Danafra/Zaribo-MK2/STL/Y-axis/Read me.txt

# of parts needed:

Part name:			Amount:
y-BeltHolder MK2		1
y-BeltTensioner-Part1		1
y-BeltTensioner-Part2		1
Y-MotorHolder			1
Y-MotorHolderSupport		1
Y-RodHolder-ZipTie		4
