Danafra/Zaribo-MK2/STL/Frame/Rambo/Read me.txt

# of parts needed:

Part name:			Amount:
RamboBox-Mosfet-Body		1
RamboBox-Mosfet-Cover		1
