Danafra/Zaribo-MK2/STEP/Frame/Frame Components/ExtrusionCover-4x-2.0.step

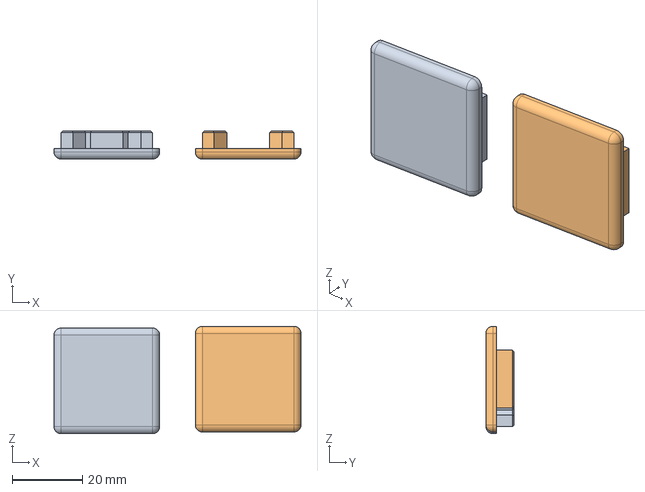
[picture p1: CAD file, 2018-03-04]
STEP/Frame/Frame Components/ExtrusionCover-4x-2.0.step
70.1 x 8.02 x 30.5 mm
