Danafra/Zaribo-MK2/STEP/Frame/PSU/PSU-Z-Connector-1x-2.0.step

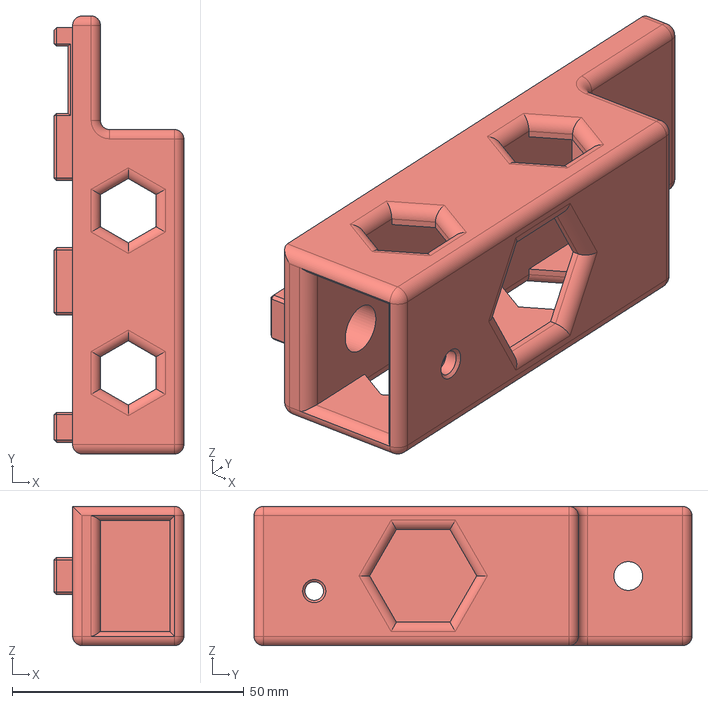
[picture p2: CAD file, 2018-03-04]
STEP/Frame/PSU/PSU-Z-Connector-1x-2.0.step
28.0 x 94.5 x 30.0 mm
