Danafra/Zaribo-MK2/STEP/Frame/Rambo/RamboBox-Mosfet-1x-2.0 v1.step

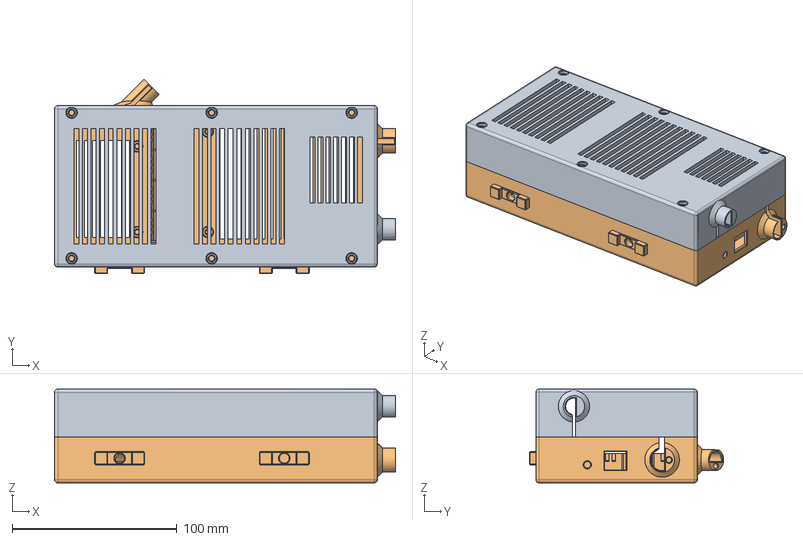
[picture p3: CAD file, 2018-03-04]
STEP/Frame/Rambo/RamboBox-Mosfet-1x-2.0 v1.step
207.0 x 118.0 x 57.0 mm
