Danafra/Zaribo-MK2/STEP/Frame/Spoolholder/Spooholder-1x-2.0.step

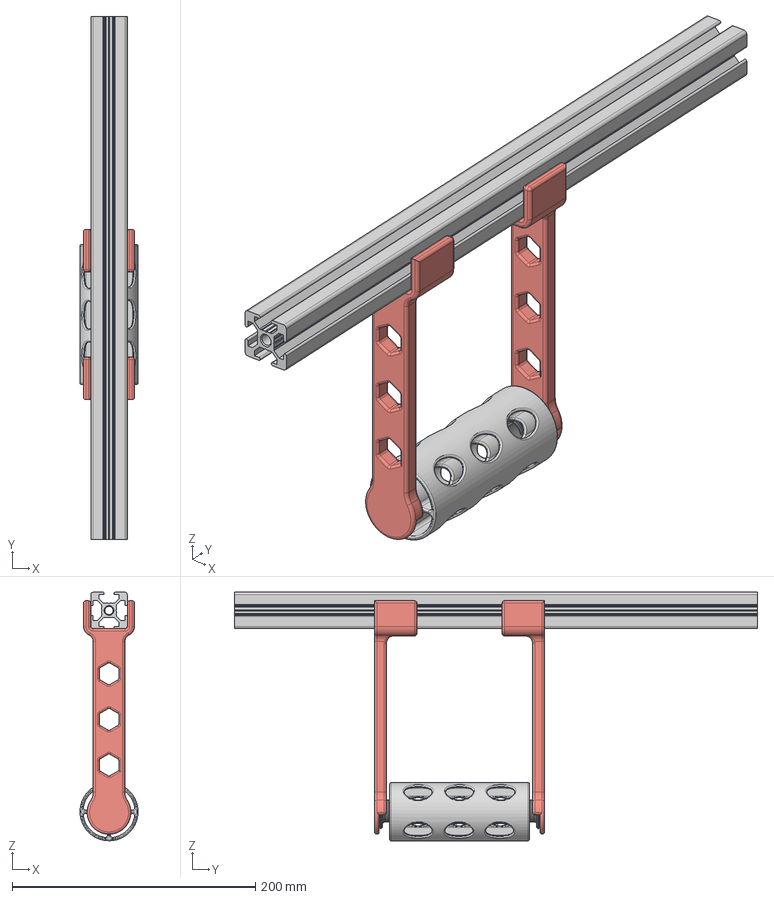
[picture p4: CAD file, 2018-03-04]
STEP/Frame/Spoolholder/Spooholder-1x-2.0.step
47.8 x 430.0 x 204.4 mm
GFS6-3030-430-TPW v1
SpindleHolder
Spool
