Danafra/Zaribo-MK2/STEP/optional/Z-TopMount-Right-Wide-1x-2.0.stl

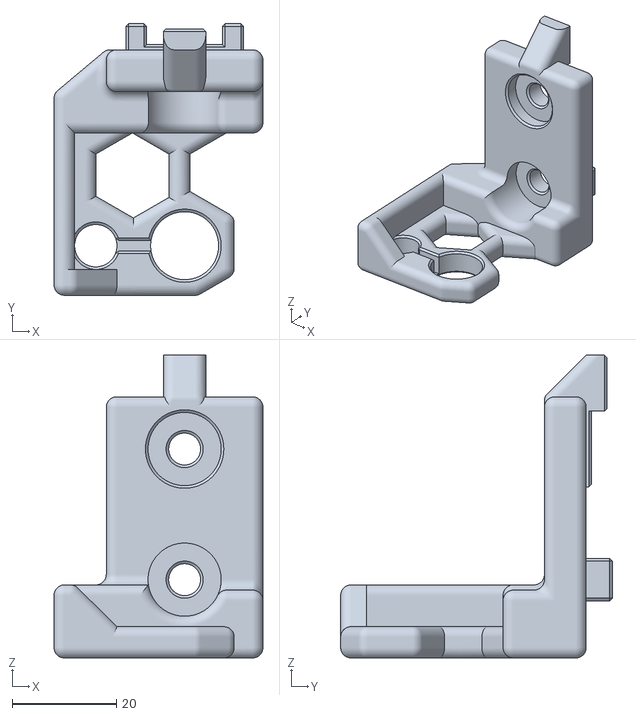
[picture p5: CAD file, 2018-03-04]
STEP/optional/Z-TopMount-Right-Wide-1x-2.0.stl
40.0 x 52.0 x 58.0
