Danafra/Zaribo-MK2/STEP/Y-axis/Y-RodHolder-ZipTie-4x-2.0.step

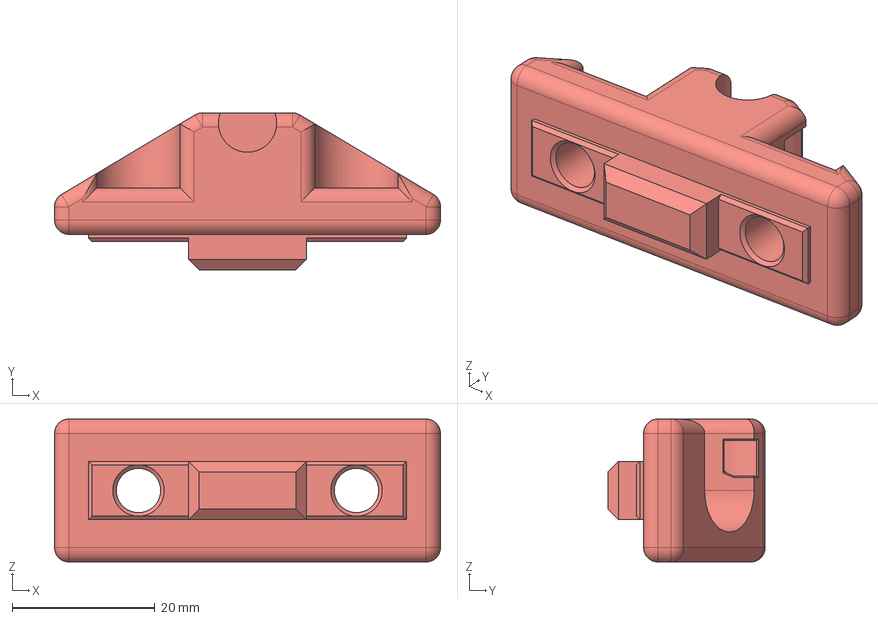
[picture p6: CAD file, 2018-03-25]
STEP/Y-axis/Y-RodHolder-ZipTie-4x-2.0.step
54.0 x 22.0 x 20.0 mm
