Danafra/Zaribo-MK2/STEP/ZariboCalibration-1x-2.0.step

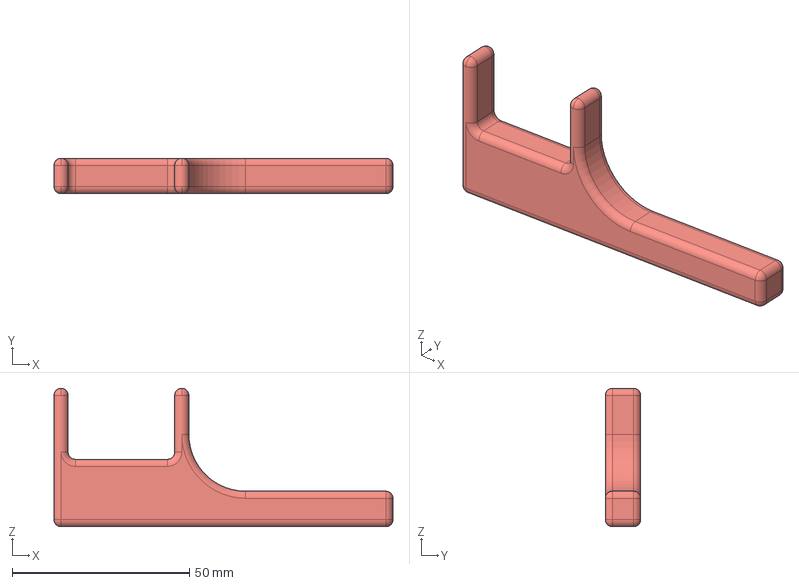
[picture p7: CAD file, 2018-03-04]
STEP/ZariboCalibration-1x-2.0.step
95.5 x 10.0 x 39.0 mm
