Danafra/Zaribo-MK2/STL/Extruder/ExtruderIder-1x-2.0.stl

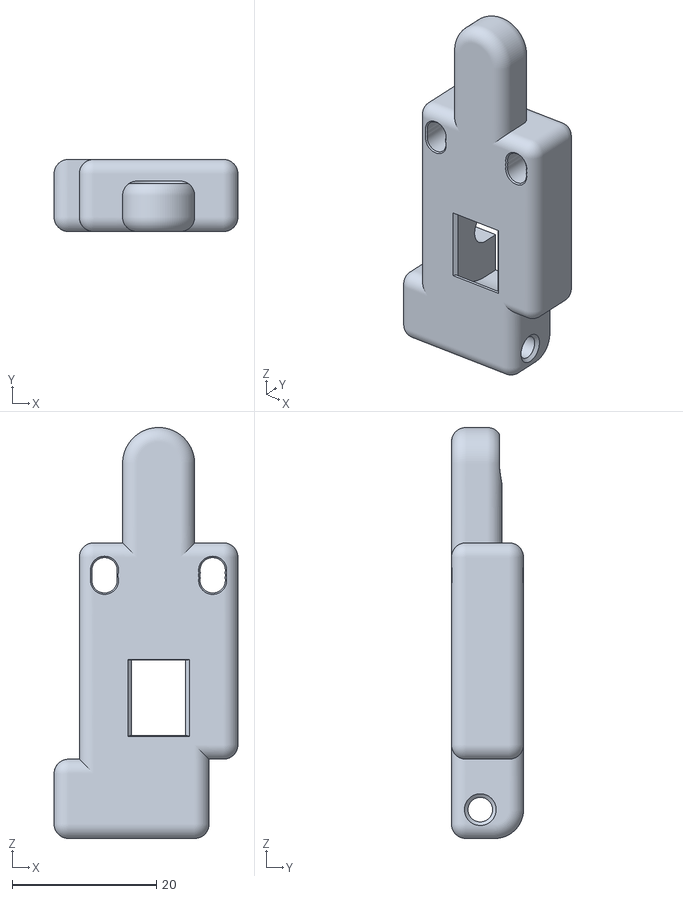
[picture p8: CAD file, 2018-03-04]
STL/Extruder/ExtruderIder-1x-2.0.stl
25.5 x 10.00 x 57.0
