Danafra/Zaribo-MK2/STL/Frame/Frame Components/Bracket-L-Left-3x-2.0.stl

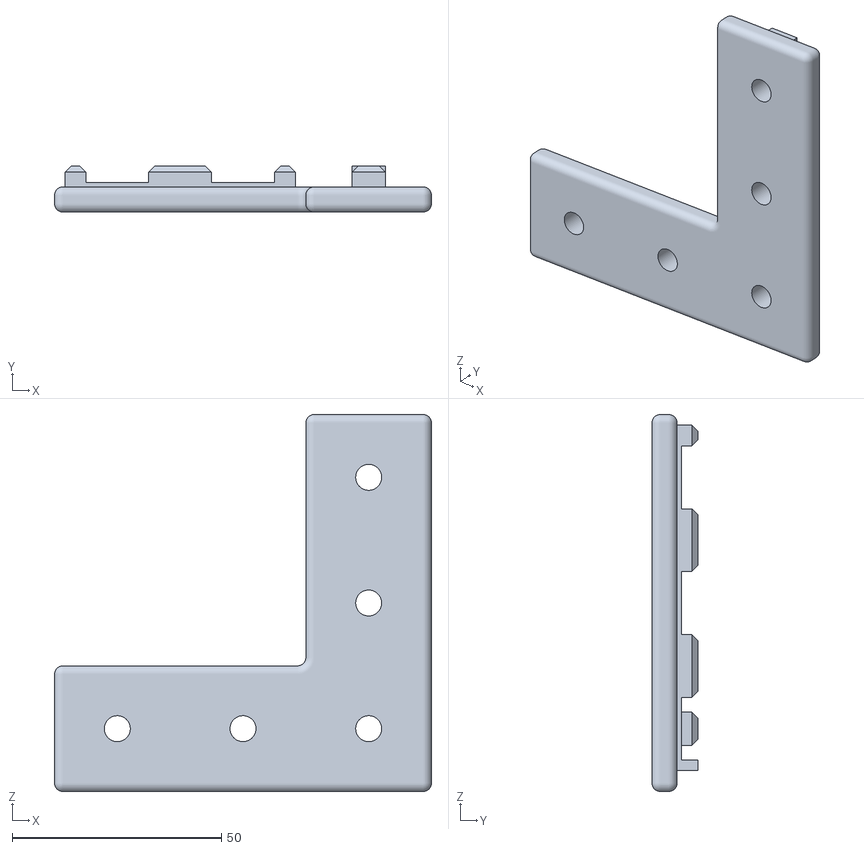
[picture p9: CAD file, 2018-03-04]
STL/Frame/Frame Components/Bracket-L-Left-3x-2.0.stl
90.0 x 11.0 x 90.0
