Danafra/Zaribo-MK2/STL/Frame/LCD/LCD-cover-Zaribo-1x-2.0.stl

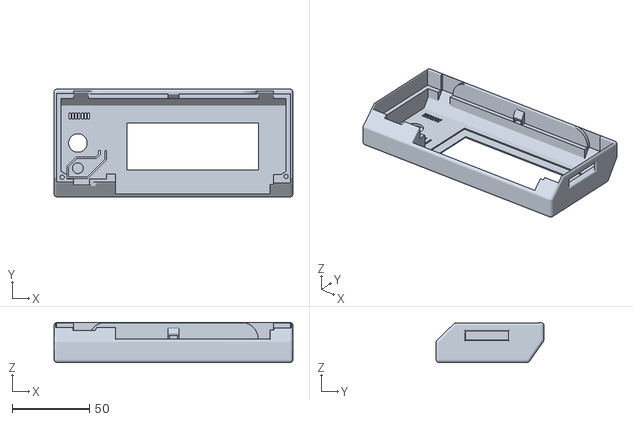
[picture p10: CAD file, 2018-03-09]
STL/Frame/LCD/LCD-cover-Zaribo-1x-2.0.stl
155.0 x 70.0 x 26.0
