Danafra/Zaribo-MK2/STL/Frame/Rambo/RamboBox-Mosfet-Cover-1x-2.0.stl

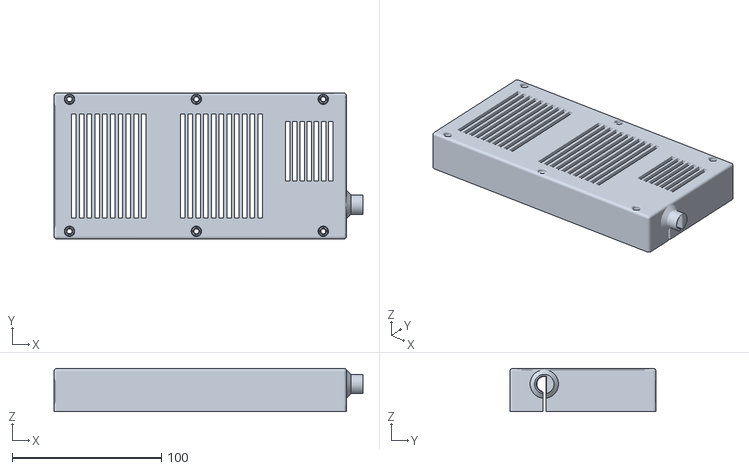
[picture p11: CAD file, 2018-03-04]
STL/Frame/Rambo/RamboBox-Mosfet-Cover-1x-2.0.stl
207.0 x 98.0 x 29.0
