Danafra/Zaribo-MK2/STL/Frame/Spoolholder/SpoolMount-2x-2.0.stl

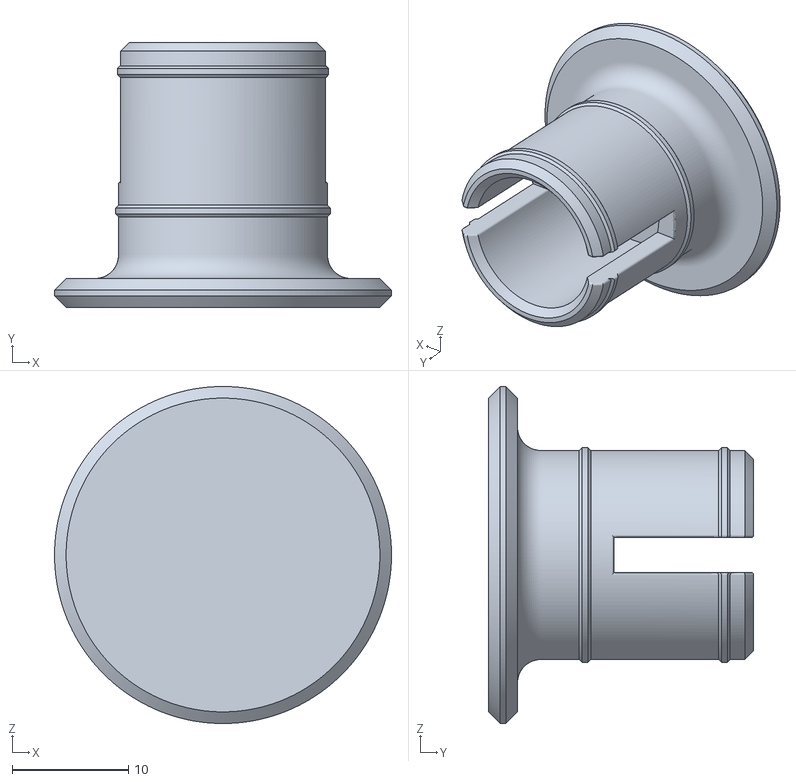
[picture p12: CAD file, 2018-03-04]
STL/Frame/Spoolholder/SpoolMount-2x-2.0.stl
29.0 x 22.8 x 29.0
