Danafra/Zaribo-MK2/STL/X-axis/Carriage/x-CarriageCableSupport-1x-2.0.stl

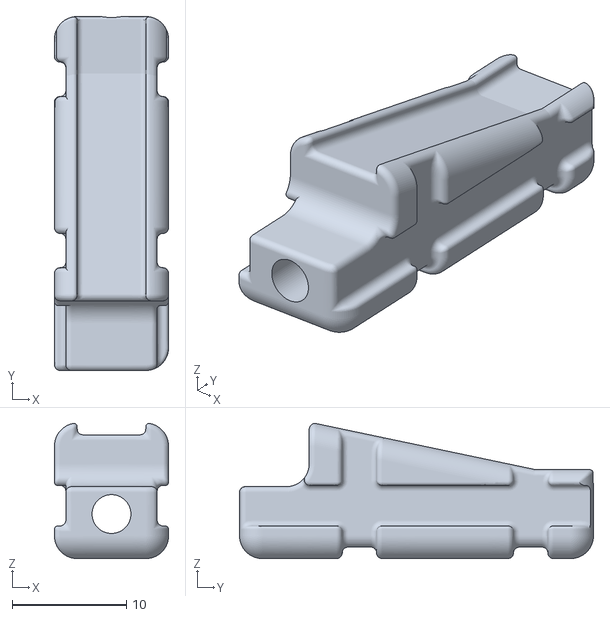
[picture p13: CAD file, 2018-03-04]
STL/X-axis/Carriage/x-CarriageCableSupport-1x-2.0.stl
10.0 x 31.0 x 11.8
