Danafra/Zaribo-MK2/STL/X-axis/X-axis mount/x-Idler-1x-2.1.stl

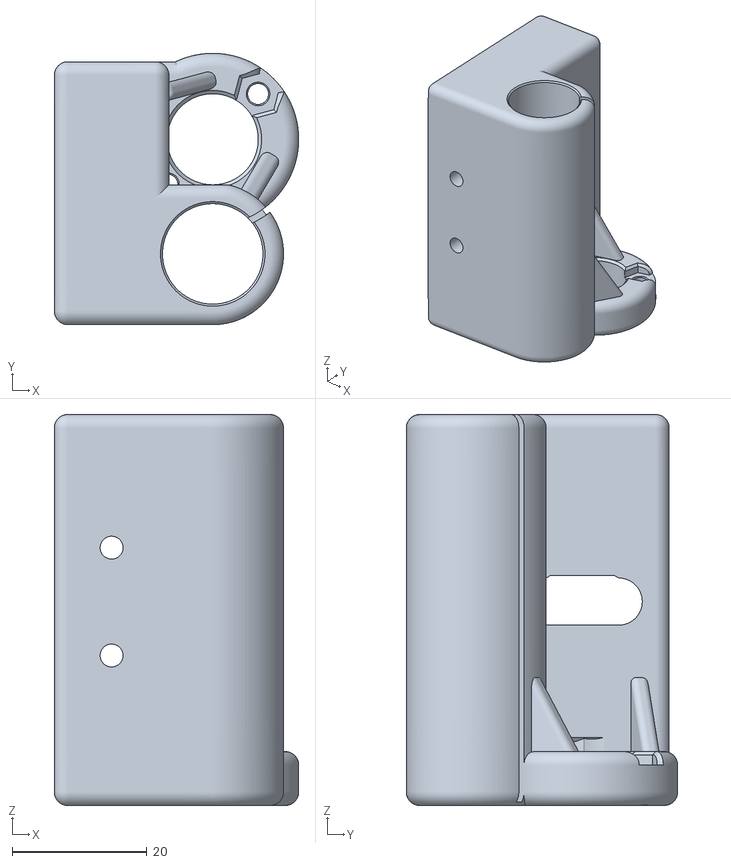
[picture p14: CAD file, 2018-03-04]
STL/X-axis/X-axis mount/x-Idler-1x-2.1.stl
36.2 x 40.2 x 58.0
