Danafra/Zaribo-MK2/STL/Y-axis/y-BearingHousing-3x.stl

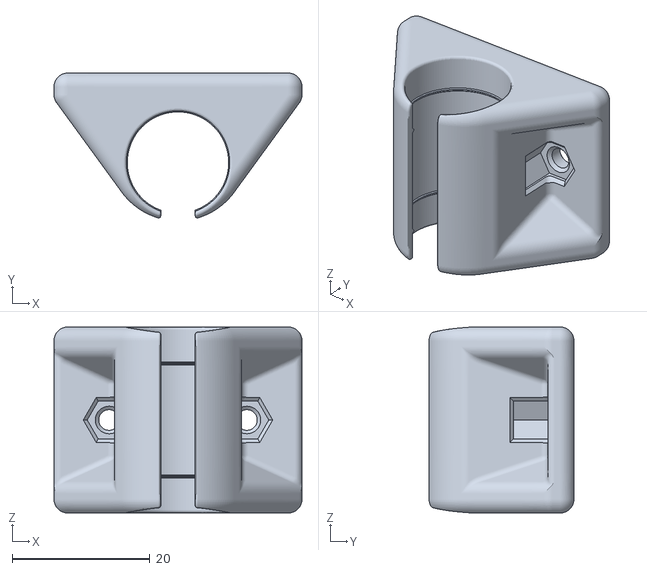
[picture p15: CAD file, 2018-03-25]
STL/Y-axis/y-BearingHousing-3x.stl
36.0 x 21.0 x 27.0
