Danafra/Zaribo-MK2/STL/Z-axis/Z-MotorMount-Right-1x-2.0.stl

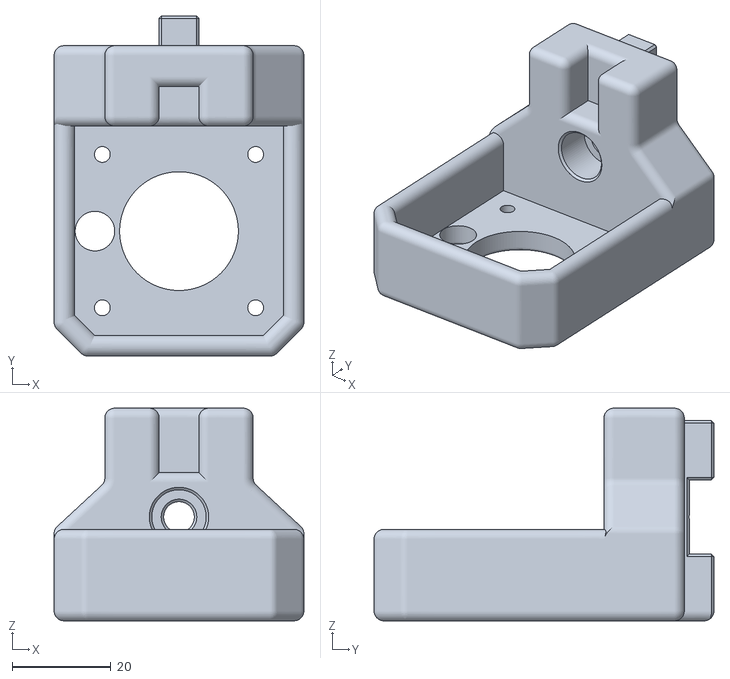
[picture p16: CAD file, 2018-03-04]
STL/Z-axis/Z-MotorMount-Right-1x-2.0.stl
50.5 x 68.8 x 43.0
