Danafra/Zaribo-MK2/STEP/Frame/Frame Components/ExtrusionSlotCover-4x-2.0.step

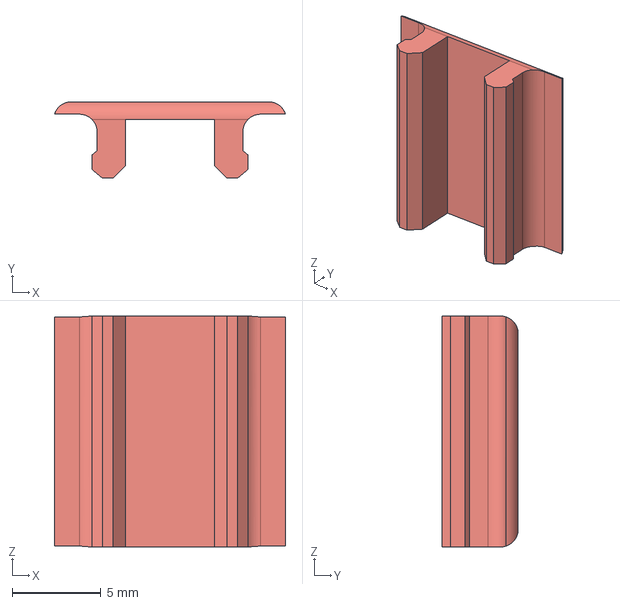
[picture p17: CAD file, 2018-03-04]
STEP/Frame/Frame Components/ExtrusionSlotCover-4x-2.0.step
13.0 x 4.30 x 13.0 mm
