Danafra/Zaribo-MK2/STEP/Frame/PSU/PSU-zHolder-SwitchPlug-1x-2.0.step

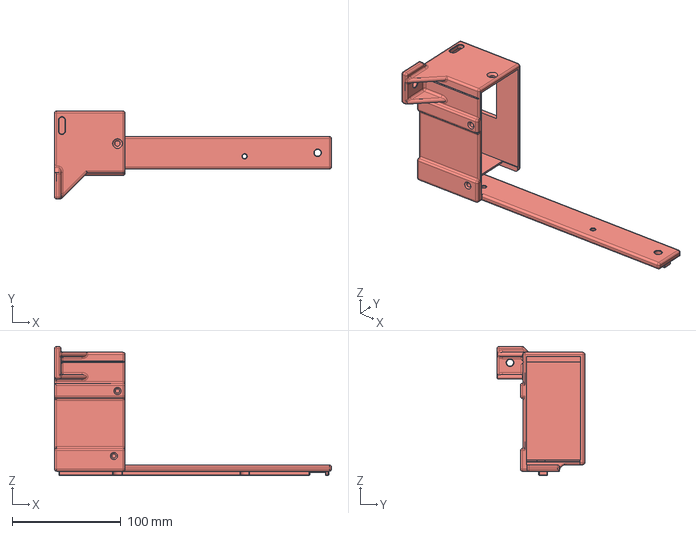
[picture p18: CAD file, 2018-03-04]
STEP/Frame/PSU/PSU-zHolder-SwitchPlug-1x-2.0.step
255.0 x 81.0 x 119.0 mm
