Danafra/Zaribo-MK2/STEP/Y-axis/y-BeltHolder MK2-1x-2.0.step

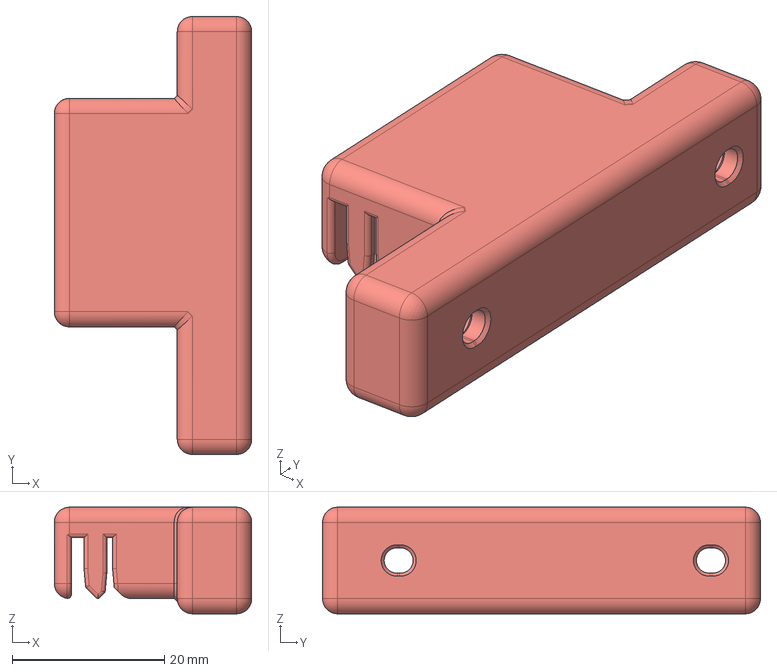
[picture p19: CAD file, 2018-03-25]
STEP/Y-axis/y-BeltHolder MK2-1x-2.0.step
25.9 x 57.5 x 14.0 mm
