Danafra/Zaribo-MK2/STEP/Z-axis/Z-MotorMount-1x-2.0.step

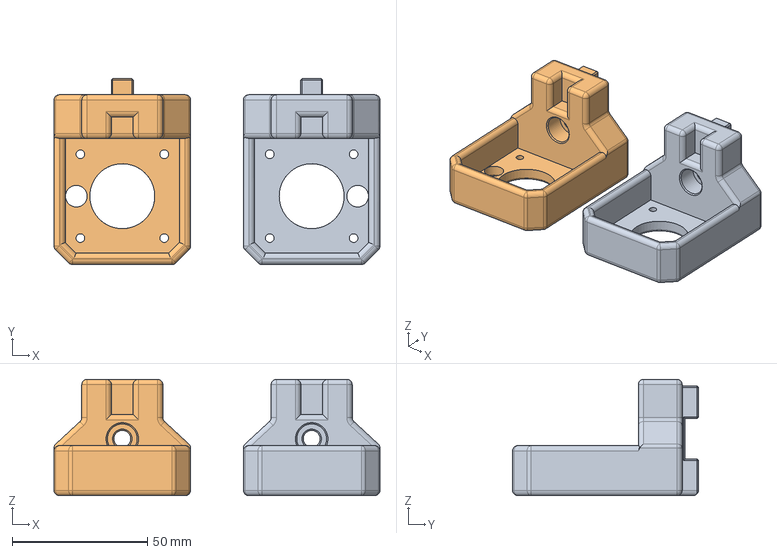
[picture p20: CAD file, 2018-03-04]
STEP/Z-axis/Z-MotorMount-1x-2.0.step
120.5 x 68.8 x 43.0 mm
