Danafra/Zaribo-MK2/STL/Extruder/FanNozzleWide-1x-2.1.stl

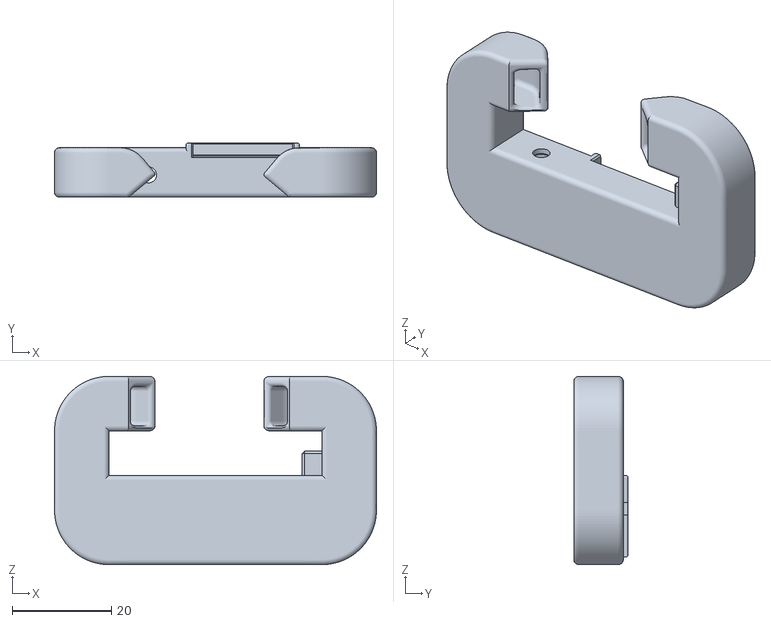
[picture p21: CAD file, 2018-03-04]
STL/Extruder/FanNozzleWide-1x-2.1.stl
65.0 x 11.0 x 38.0
