Danafra/Zaribo-MK2/STL/Frame/LCD/LCD-Mount-right-1x-2.0.stl

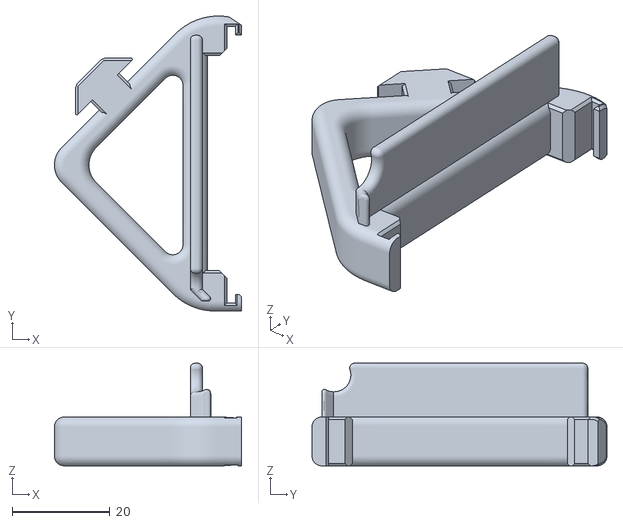
[picture p22: CAD file, 2018-03-09]
STL/Frame/LCD/LCD-Mount-right-1x-2.0.stl
38.3 x 60.4 x 21.0
