Danafra/Zaribo-MK2/STL/Frame/Rambo/RamboBox-Mosfet-Body-1x-2.0.stl

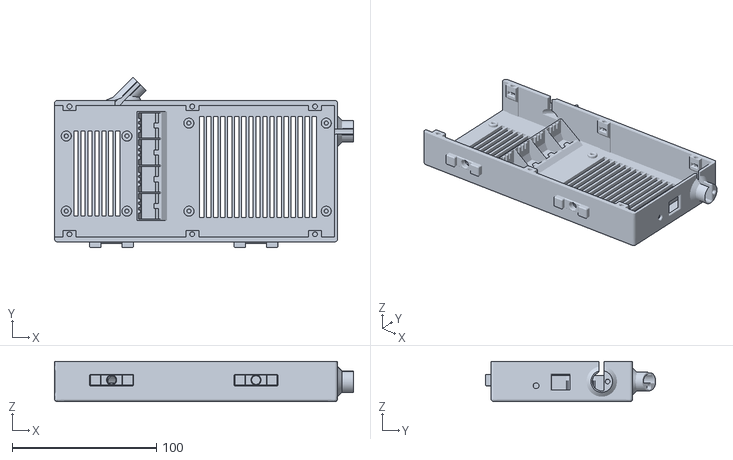
[picture p23: CAD file, 2018-03-04]
STL/Frame/Rambo/RamboBox-Mosfet-Body-1x-2.0.stl
207.0 x 118.0 x 28.0
