Danafra/Zaribo-MK2/STL/Frame/Spoolholder/SpooholderArm-2x-2.0.stl

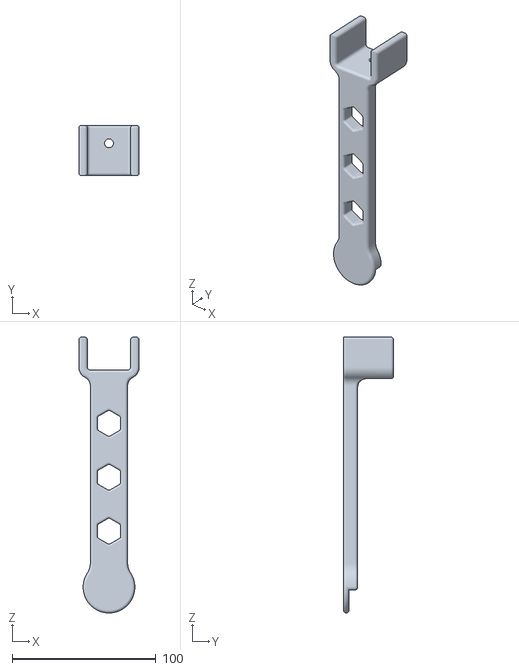
[picture p24: CAD file, 2018-03-04]
STL/Frame/Spoolholder/SpooholderArm-2x-2.0.stl
42.0 x 35.0 x 192.0
