Danafra/Zaribo-MK2/STL/X-axis/Carriage/x-CarriageBearingCover2-1x-2.0.stl

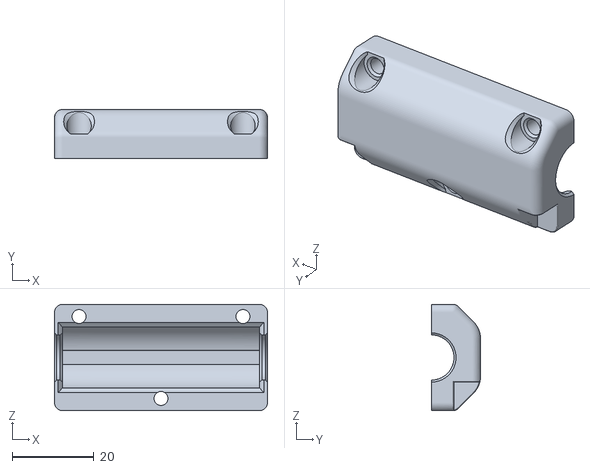
[picture p25: CAD file, 2018-03-04]
STL/X-axis/Carriage/x-CarriageBearingCover2-1x-2.0.stl
52.0 x 12.0 x 26.0
