Danafra/Zaribo-MK2/STL/X-axis/X-axis mount/x-BeltTensioner-Part2-1x-2.1.stl

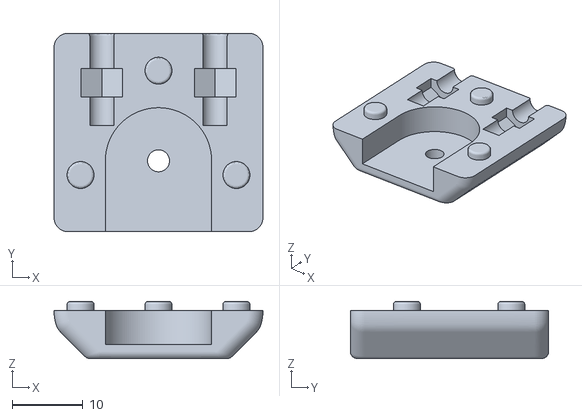
[picture p26: CAD file, 2018-03-04]
STL/X-axis/X-axis mount/x-BeltTensioner-Part2-1x-2.1.stl
29.5 x 28.0 x 8.05
