Danafra/Zaribo-MK2/STL/Y-axis/y-BeltTensioner-Part2-1x-2.0.stl

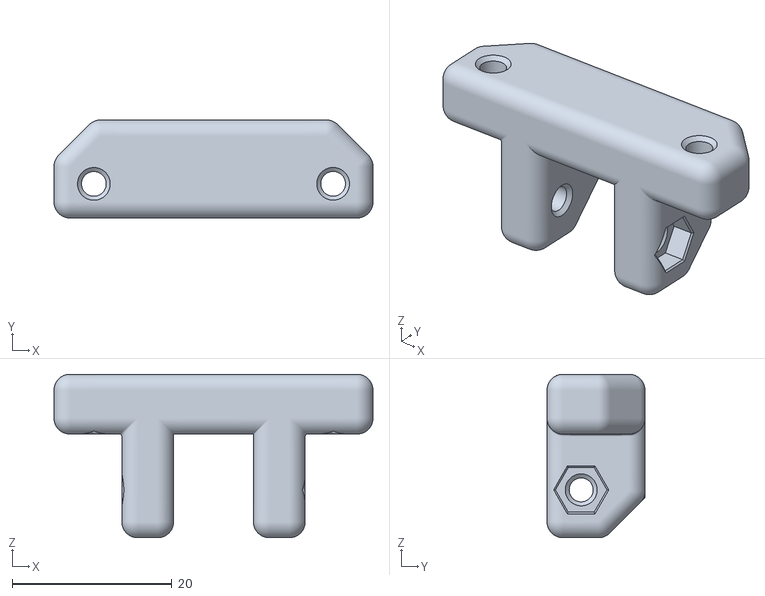
[picture p27: CAD file, 2018-03-04]
STL/Y-axis/y-BeltTensioner-Part2-1x-2.0.stl
40.0 x 12.3 x 20.5
