Danafra/Zaribo-MK2/STL/Z-axis/Z-TopMount-Right-1x-2.0.stl

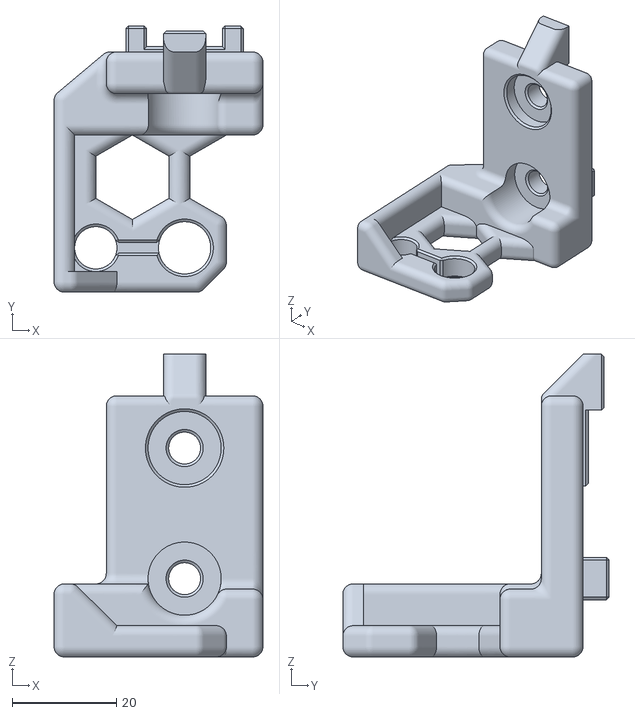
[picture p28: CAD file, 2018-03-04]
STL/Z-axis/Z-TopMount-Right-1x-2.0.stl
40.0 x 51.0 x 58.0
