Danafra/Zaribo-MK2/STEP/Frame/Frame Components/Bracket-T-2x-2.0.step

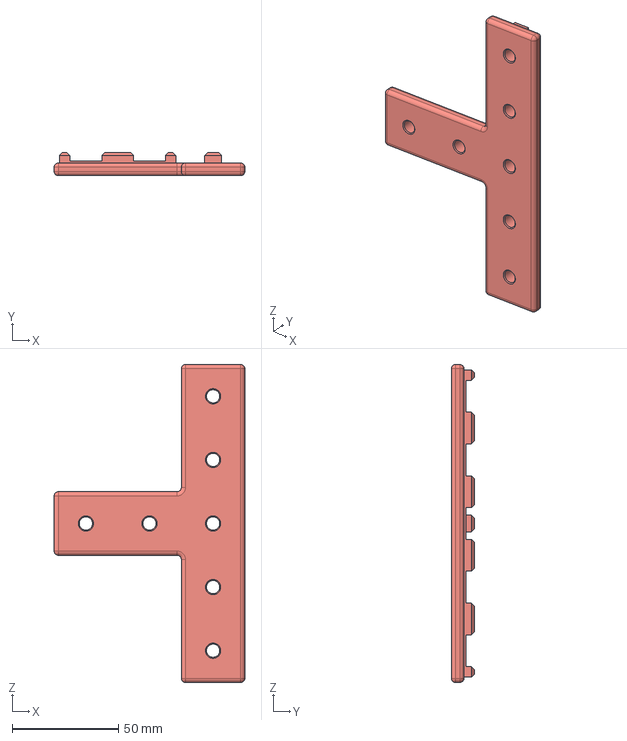
[picture p29: CAD file, 2018-03-04]
STEP/Frame/Frame Components/Bracket-T-2x-2.0.step
90.0 x 11.0 x 150.0 mm
