Danafra/Zaribo-MK2/STEP/Y-axis/y-BeltTensioner-1x-2.0.step

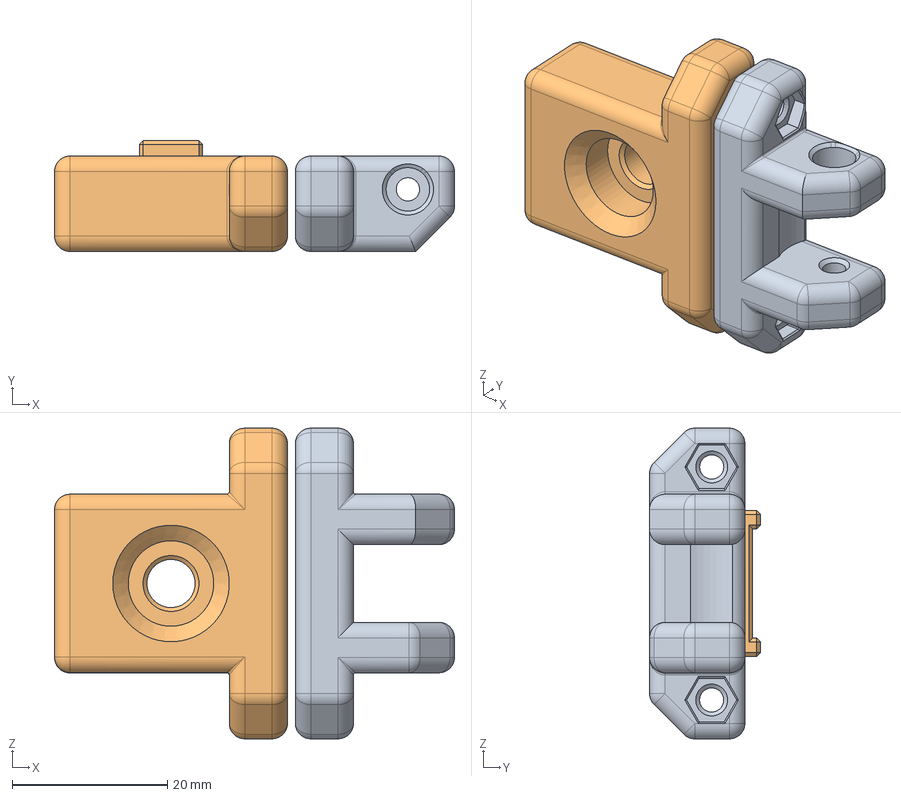
[picture p31: CAD file, 2018-03-25]
STEP/Y-axis/y-BeltTensioner-1x-2.0.step
51.5 x 14.3 x 40.0 mm
