Danafra/Zaribo-MK2/STEP/Z-axis/Z-TopMount-1x-2.0.step

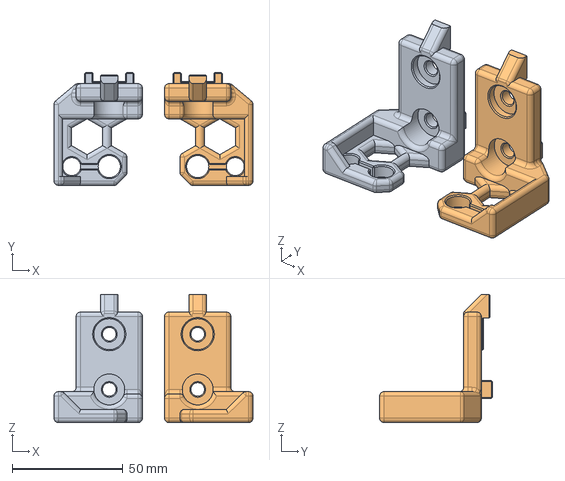
[picture p32: CAD file, 2018-03-04]
STEP/Z-axis/Z-TopMount-1x-2.0.step
90.0 x 51.0 x 58.0 mm
