Danafra/Zaribo-MK2/STL/Extruder/ExtruderBody-1x-2.0.stl

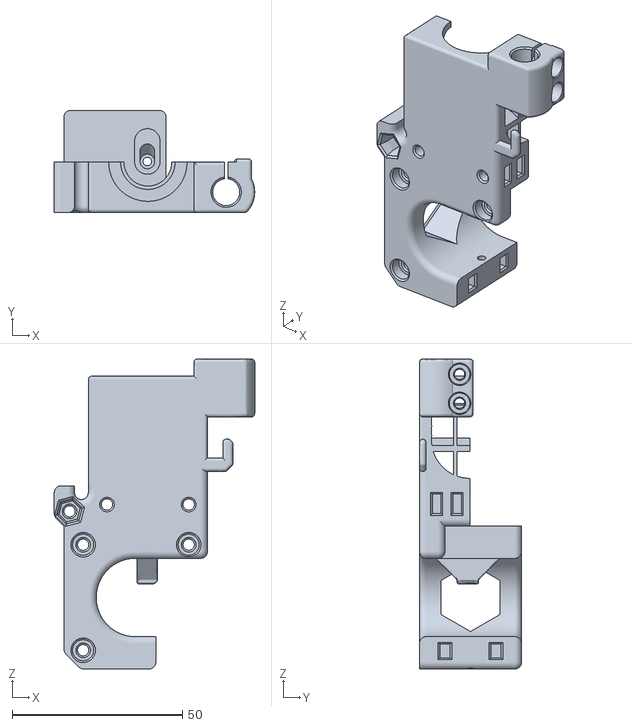
[picture p33: CAD file, 2018-03-04]
STL/Extruder/ExtruderBody-1x-2.0.stl
58.9 x 30.0 x 91.0
