Danafra/Zaribo-MK2/STL/Frame/Frame Components/ExtrusionCover-2Legs-2x-2.0.stl

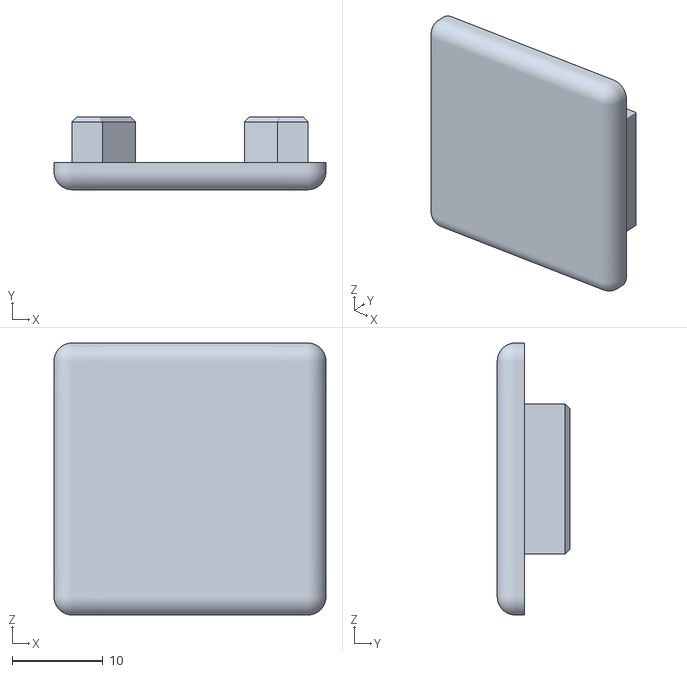
[picture p34: CAD file, 2018-03-04]
STL/Frame/Frame Components/ExtrusionCover-2Legs-2x-2.0.stl
30.0 x 8.00 x 30.0
