Danafra/Zaribo-MK2/STL/X-axis/Carriage/x-Carriage-MK2-1x-2.0.stl

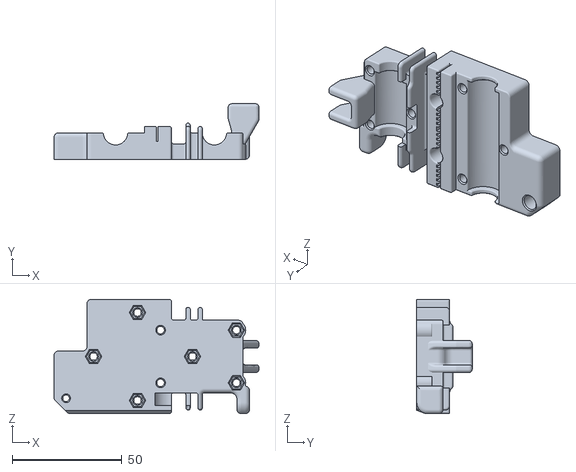
[picture p36: CAD file, 2018-03-04]
STL/X-axis/Carriage/x-Carriage-MK2-1x-2.0.stl
93.3 x 25.3 x 52.0
