Danafra/Zaribo-MK2/STL/X-axis/X-axis mount/x-MotorHolder-1x-2.1.stl

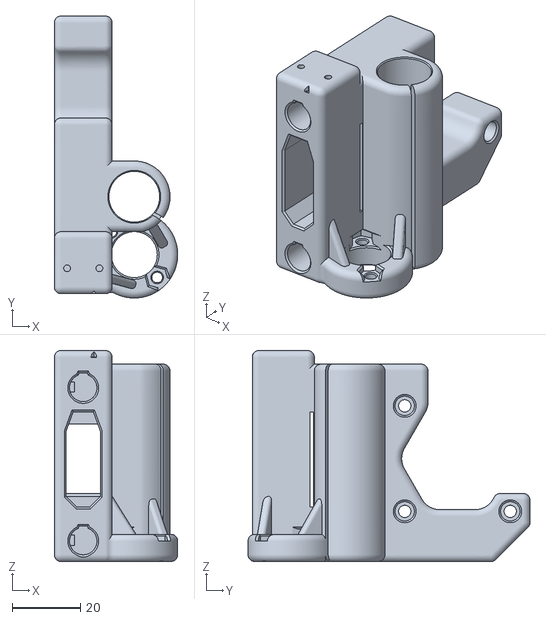
[picture p37: CAD file, 2018-03-04]
STL/X-axis/X-axis mount/x-MotorHolder-1x-2.1.stl
36.2 x 82.8 x 62.0
