Danafra/Zaribo-MK2/STL/Y-axis/Y-MotorHolderSupport-1x-2.0.stl

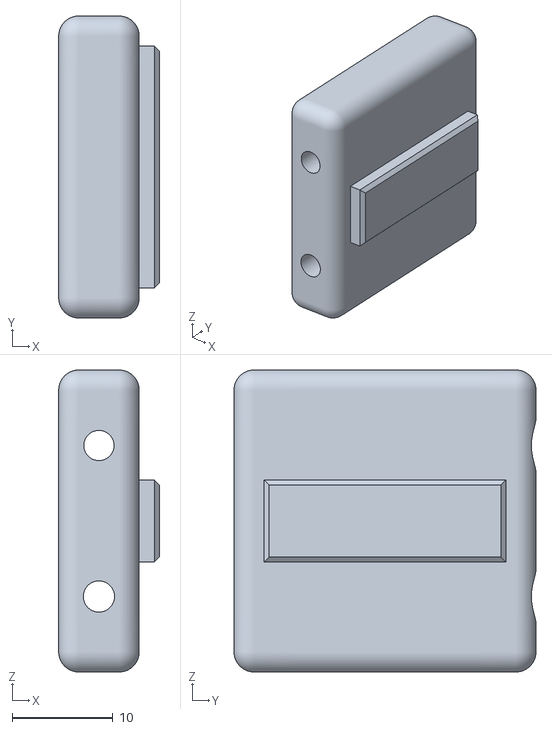
[picture p38: CAD file, 2018-03-04]
STL/Y-axis/Y-MotorHolderSupport-1x-2.0.stl
10.0 x 30.0 x 30.0
