Danafra/Zaribo-MK2/STEP/Frame/Frame Components/Bracket-L-3x-2.0.step

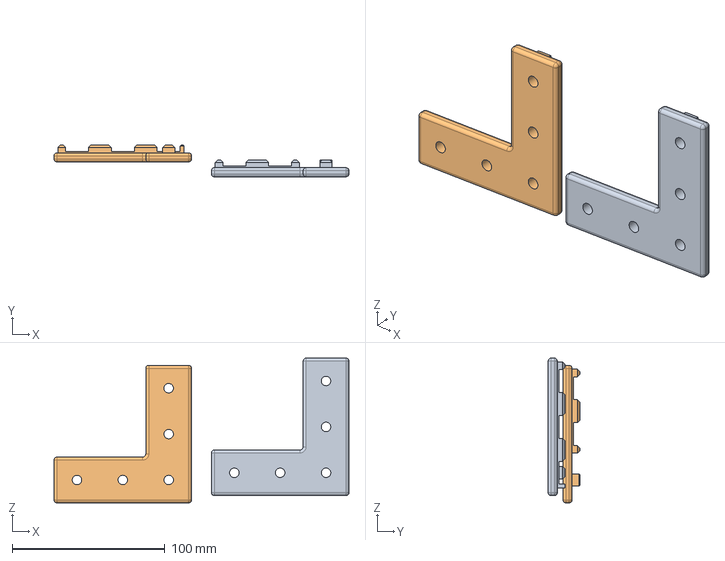
[picture p39: CAD file, 2018-03-04]
STEP/Frame/Frame Components/Bracket-L-3x-2.0.step
192.9 x 20.7 x 94.7 mm
