Danafra/Zaribo-MK2/STEP/Frame/PSU/PSU-Housing-1x-2.0.step

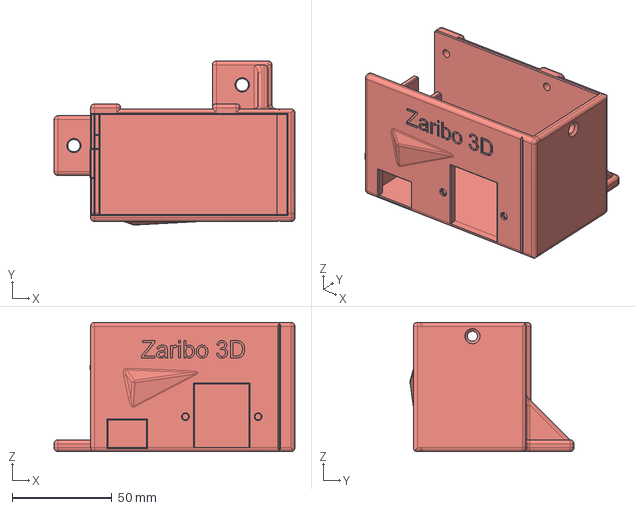
[picture p40: CAD file, 2018-03-04]
STEP/Frame/PSU/PSU-Housing-1x-2.0.step
121.0 x 82.4 x 65.0 mm
