Danafra/Zaribo-MK2/STL/Frame/Frame Components/ExtrusionCover-3Legs-4x-2.0.stl

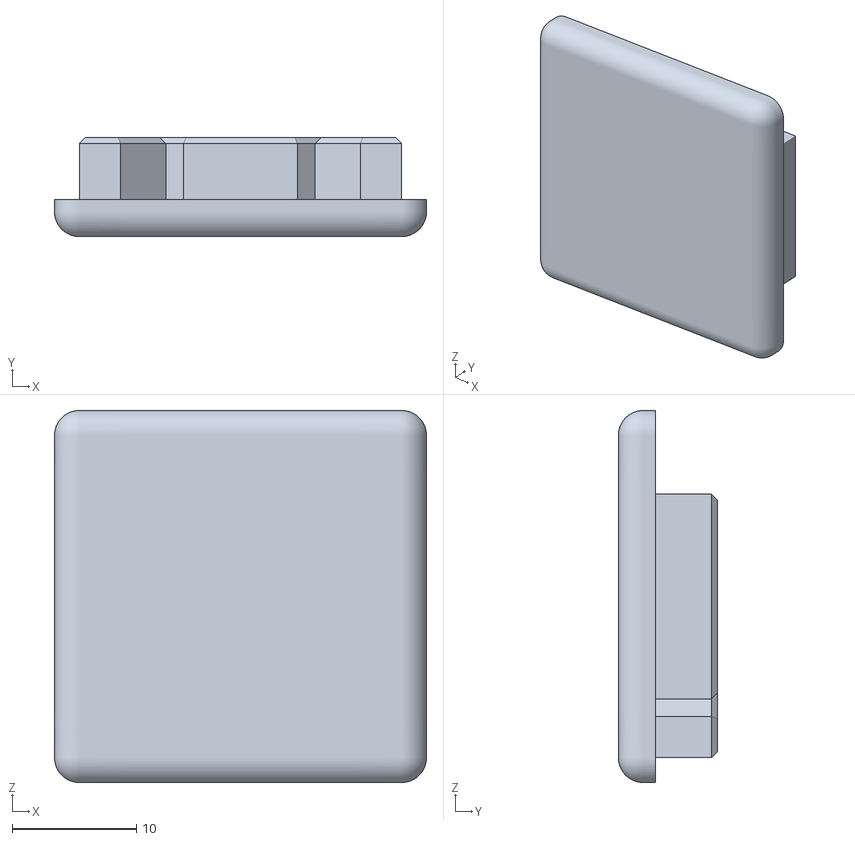
[picture p41: CAD file, 2018-03-04]
STL/Frame/Frame Components/ExtrusionCover-3Legs-4x-2.0.stl
30.0 x 8.00 x 30.0
