Danafra/Zaribo-MK2/STL/X-axis/Carriage/x-CarriageBearingCover1-1x-2.0.stl

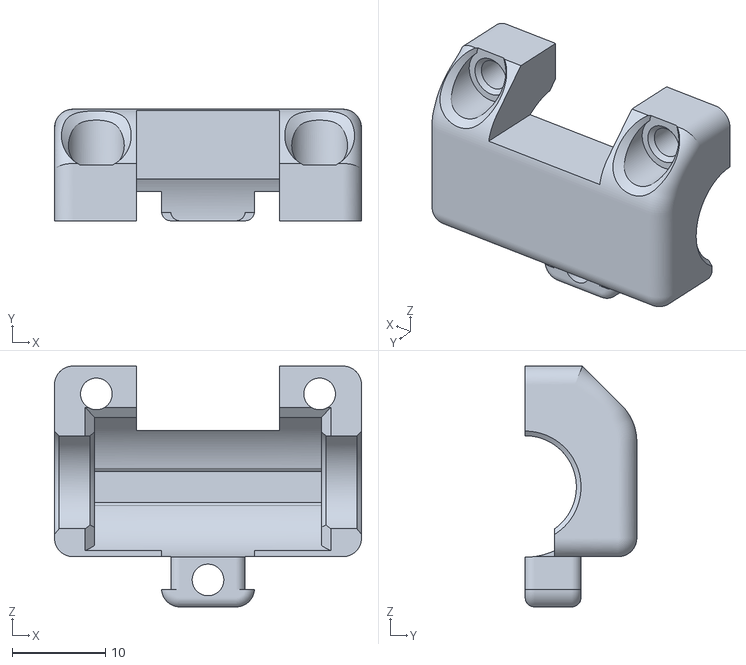
[picture p42: CAD file, 2018-03-04]
STL/X-axis/Carriage/x-CarriageBearingCover1-1x-2.0.stl
33.0 x 12.0 x 25.9
