Danafra/Zaribo-MK2/STL/X-axis/X-axis mount/x-MotorHolderCableSupport-1x-2.0.stl

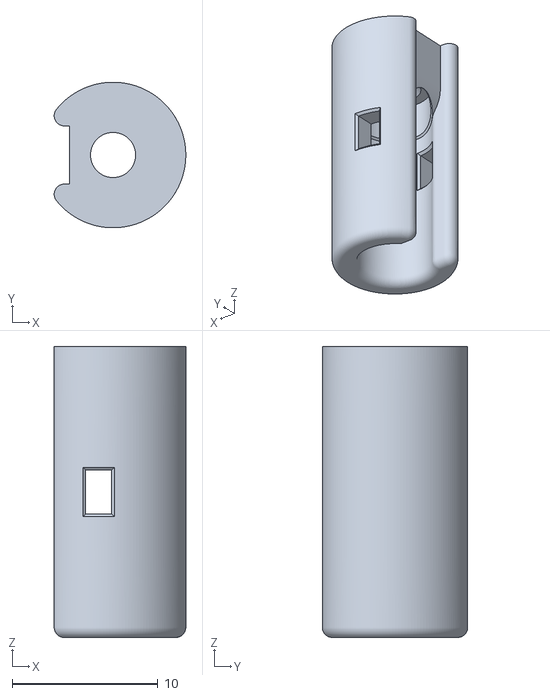
[picture p43: CAD file, 2018-03-04]
STL/X-axis/X-axis mount/x-MotorHolderCableSupport-1x-2.0.stl
9.05 x 10.00 x 20.0
