Danafra/Zaribo-MK2/STL/Y-axis/y-BeltTensioner-Part1-1x-2.0.stl

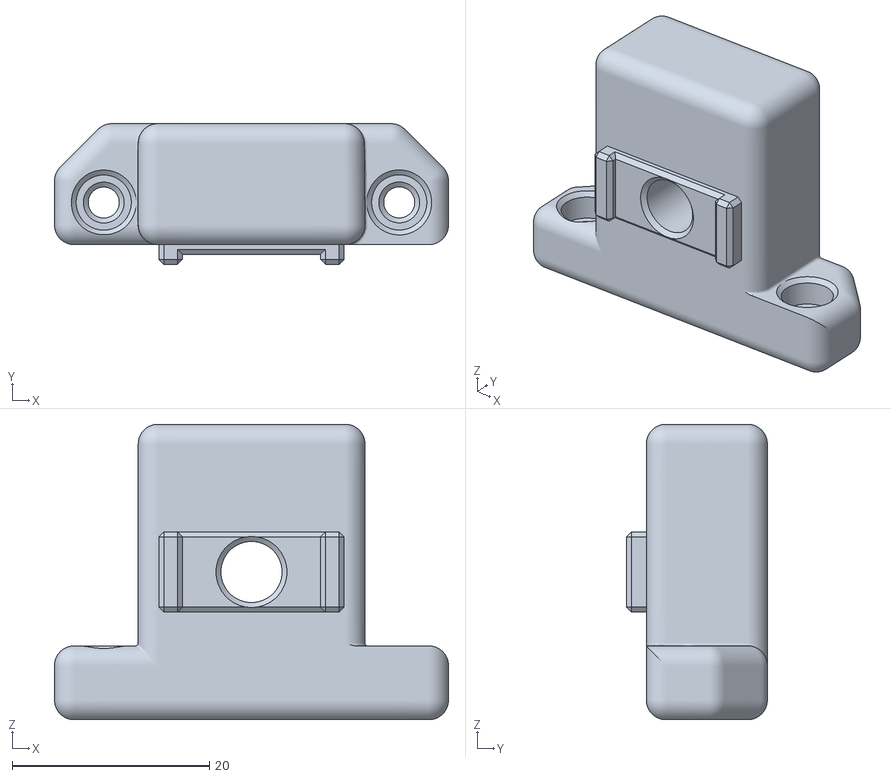
[picture p44: CAD file, 2018-03-04]
STL/Y-axis/y-BeltTensioner-Part1-1x-2.0.stl
40.0 x 14.3 x 30.0
