Danafra/Zaribo-MK2/STL/Extruder/ExtruderCover-1x-2.0.stl

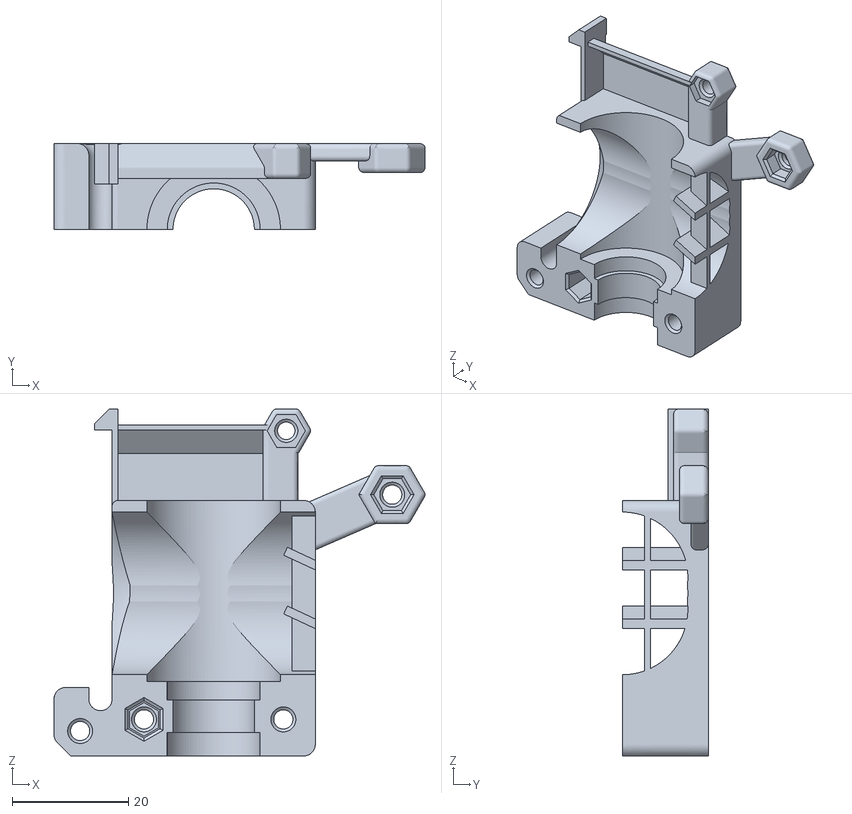
[picture p46: CAD file, 2018-03-04]
STL/Extruder/ExtruderCover-1x-2.0.stl
63.9 x 14.8 x 59.8
