Danafra/Zaribo-MK2/(list of files, cad)

Other CAD files:
STEP/optional/Z-TopMount-Left-Wide-1x-2.0.stl
STL/Frame/Frame Components/Bracket-L-Right-3x-2.0.stl
STL/Z-axis/Z-MotorMount-Left-1x-2.0.stl
STEP/Y-axis/BearingHousing-3x-2.0.step
STL/Extruder/BearingHousing-3x-2.0.stl
STL/Z-axis/Z-TopMount-Left-1x-2.0.stl
STEP/Z-axis/Z-ScrewCover-2x-2.0.step
STL/Frame/Frame Components/Bracket-T-2x-2.0.stl
STL/Frame/Frame Components/ExtrusionSlotCover-4x-2.0.stl
STL/Frame/PSU/PSU-Housing-1x-2.0.stl
STL/Frame/PSU/PSU-Z-Connector-1x-2.0.stl
STL/Frame/PSU/PSU-zHolder-1x-2.0.stl
STL/Frame/PSU/PSU-zHolder-SwitchPlug-1x-2.0.stl
STL/Y-axis/Y-MotorHolder-1x-2.0.stl
STL/Y-axis/Y-RodHolder-ZipTie-4x-2.0.stl
STL/Y-axis/y-BeltHolder MK2-1x-2.0.stl
STL/Z-axis/Z-ScrewCover-2x-2.0.stl
STL/ZariboCalibration-1x-2.0.stl
STL/optional/Z-TopMount-Left-Wide-1x-2.0.stl
