Danafra/Zaribo-MK2/(commit log)

2018-03-25 Add files via upload
    double export
    [BearingHousing-3x-2.0.step, Y-MotorHolder-1x-2.0.step, Y-RodHolder-ZipTie-4x-2.0.step, y-BeltHolder MK2-1x-2.0.step, y-BeltTensioner-1x-2.0.step]
2018-03-25 Add files via upload
    initial version
    [y-BearingHousing-3x.stl]
